lockdown8564/Slide_Plate_2016-2017/README.md

# Slide_Plate_2016-2017
OpenBeam slide plate for lift system during 2016-2017 season
