lockdown8564/Slide_Plate_2016-2017/SpurLCoverHoles.stl

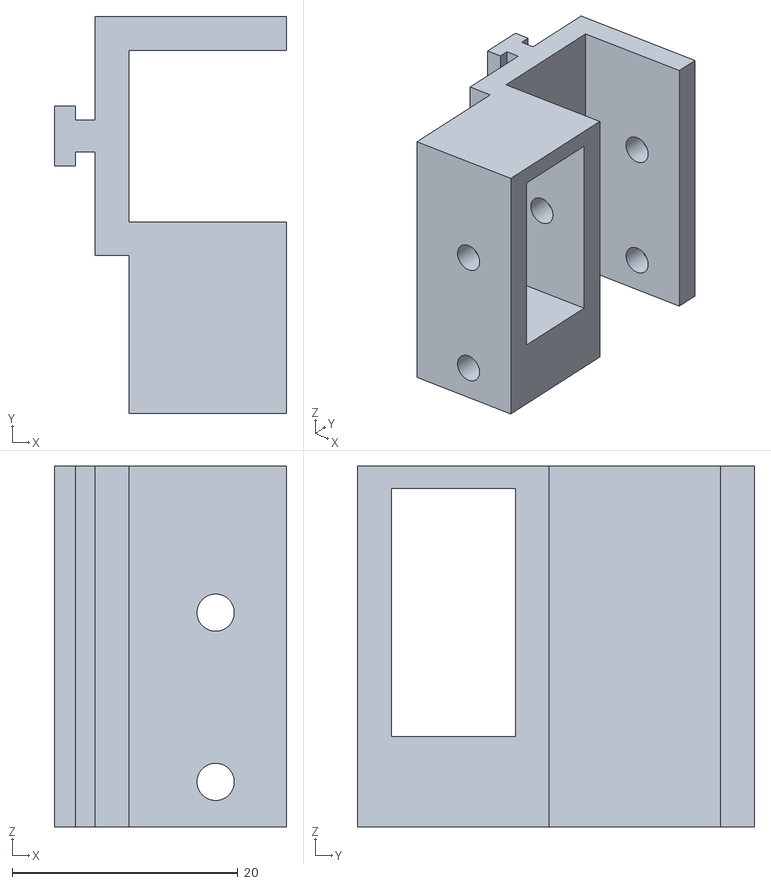
[picture p1: CAD file, 2018-01-27]
SpurLCoverHoles.stl
20.6 x 35.2 x 32.0
