lockdown8564/Slide_Plate_2016-2017/TL-400-0101-002.DXF

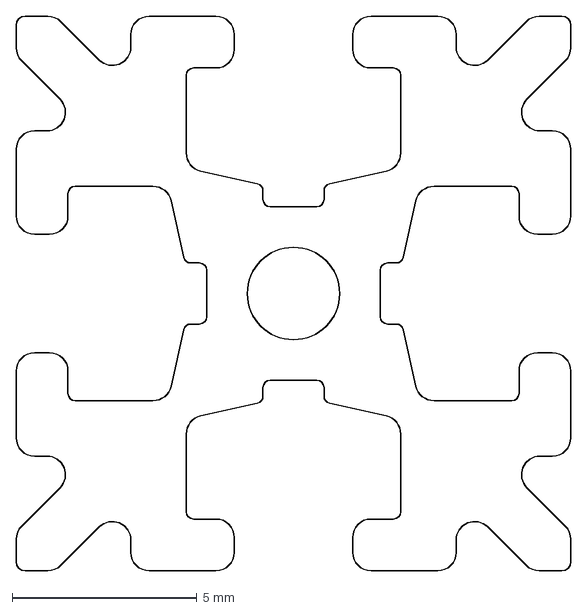
[picture p2: CAD file, 2017-11-19]
TL-400-0101-002.DXF
15.0 x 15.0 mm
