lockdown8564/Slide_Plate_2016-2017/Fork44mmHole.stl

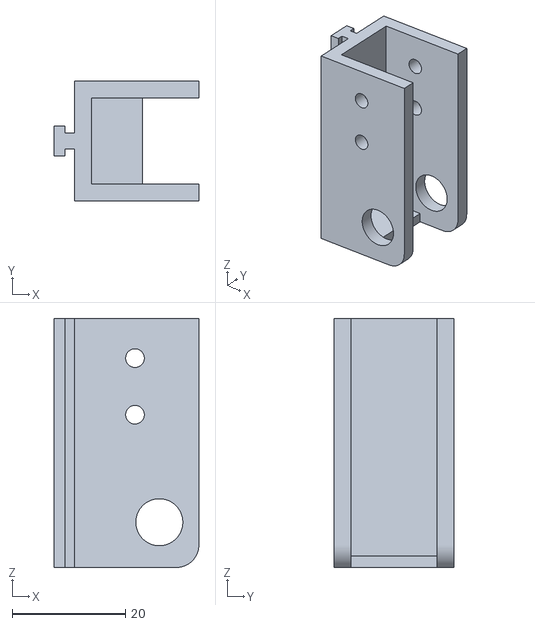
[picture p3: CAD file, 2017-11-19]
Fork44mmHole.stl
25.6 x 21.2 x 44.0
