lockdown8564/Slide_Plate_2016-2017/Spur32mmBushingHole.stl

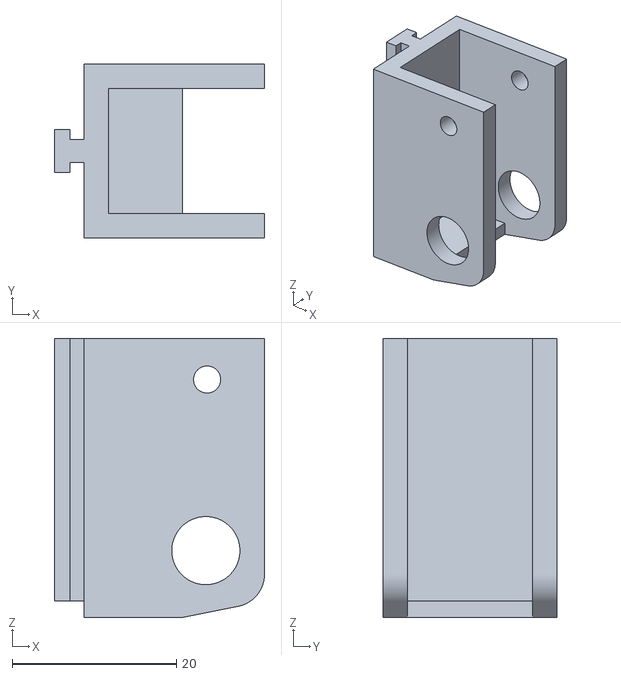
[picture p4: CAD file, 2017-11-19]
Spur32mmBushingHole.stl
25.6 x 21.2 x 34.0
