lockdown8564/Slide_Plate_2016-2017/Spur28mmHole.dxf

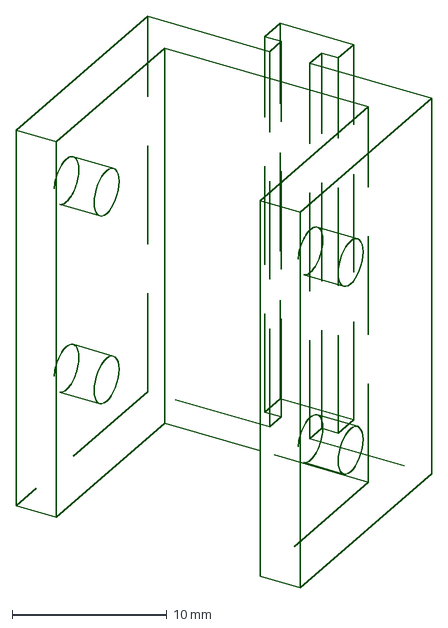
[picture p5: CAD file, 2017-11-19]
Spur28mmHole.dxf
26.9 x 36.9 mm
