lockdown8564/Slide_Plate_2016-2017/NewFork44mmHole.stl

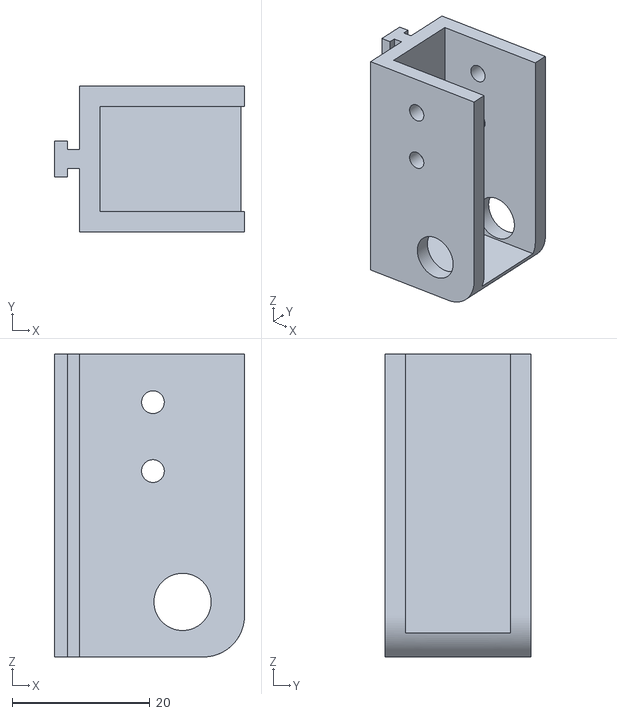
[picture p6: CAD file, 2017-11-19]
NewFork44mmHole.stl
27.6 x 21.2 x 44.0
