lockdown8564/Slide_Plate_2016-2017/b30067.stp

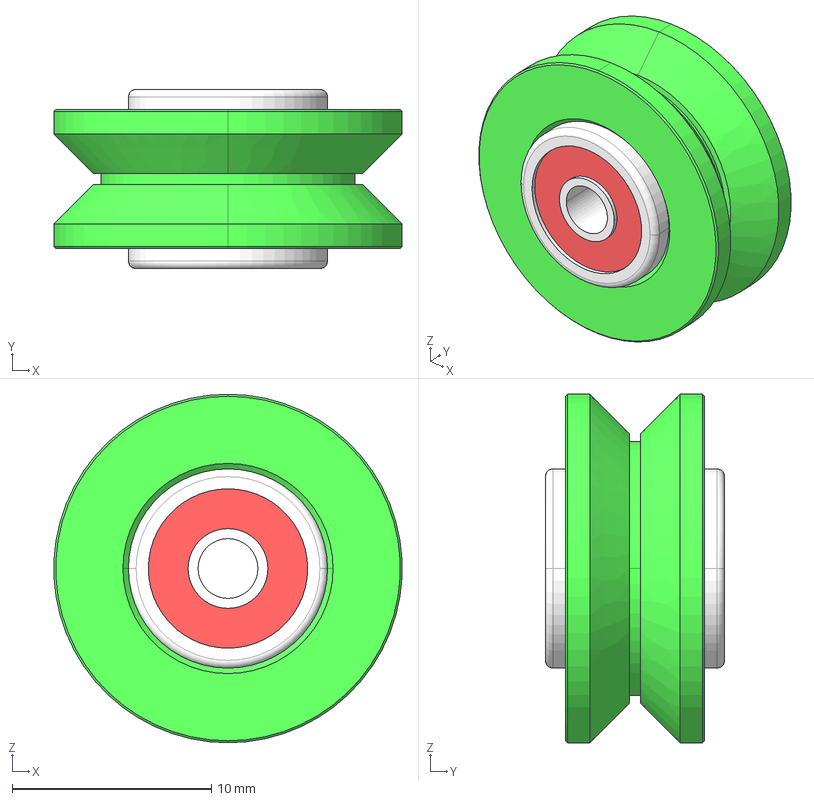
[picture p7: CAD file, 2018-02-11]
b30067.stp
17.5 x 9.00 x 17.5 mm
B17064
BEARING_3_10_4 x 2
