lockdown8564/Slide_Plate_2016-2017/217396-slide_plate_L.2.stl

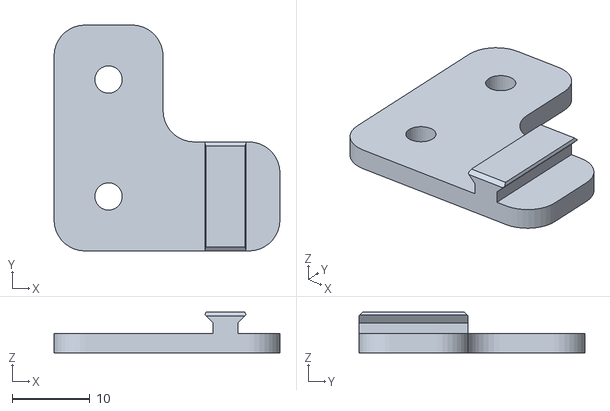
[picture p8: CAD file, 2017-11-19]
217396-slide_plate_L.2.stl
29.0 x 29.0 x 5.25
