lockdown8564/Slide_Plate_2016-2017/(list of files, cad)

Other CAD files:
SpurRCoverHoles.stl
217396-slide_plate_R.2.stl
