lockdown8564/Slide_Plate_2016-2017/(commit log)

2017-11-19 Add DesignSpark Mechanical and Autodesk 123D Design files
    [217396-slide_plate_L.2.stl, 217396-slide_plate_R.2.stl, Fork44mmHole.stl, NewFork44mmHole.stl, Spur28mmHole.dxf, Spur32mmBushingHole.stl, SpurRCoverHoles.stl, TL-400-0101-002.DXF]
2018-01-27 Add SpurLCoverHoles STL format file
    [SpurLCoverHoles.stl]
2018-02-11 Dual Bearing V-wheel
    [b30067.stp]
